mbuesch/simplepwm/schematics-atmega/simplepwm-atmega.pdf

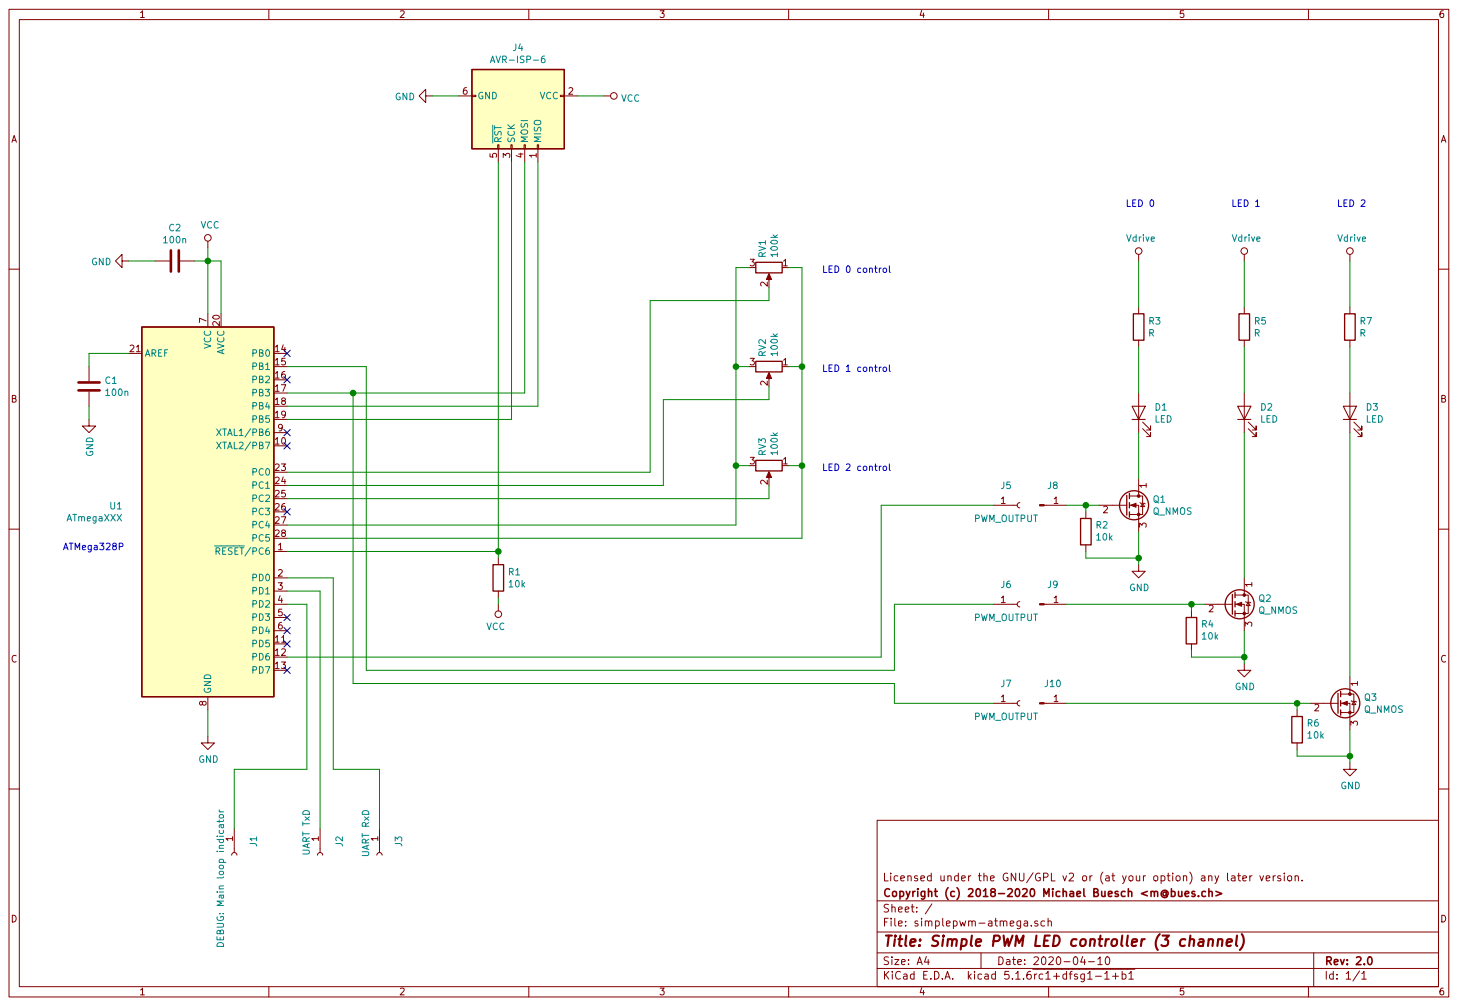
[picture p1: page 1]

LED 1 control LED 0 control

File: simplepwm-atmega.sch Sheet: / Copyright (c) 2018-2020 Michael Buesch <m@bues.ch>

Id: 1/1 Title: Simple PWM LED controller (3 channel)
