mbuesch/simplepwm/schematics-attiny/simplepwm-attiny.pdf

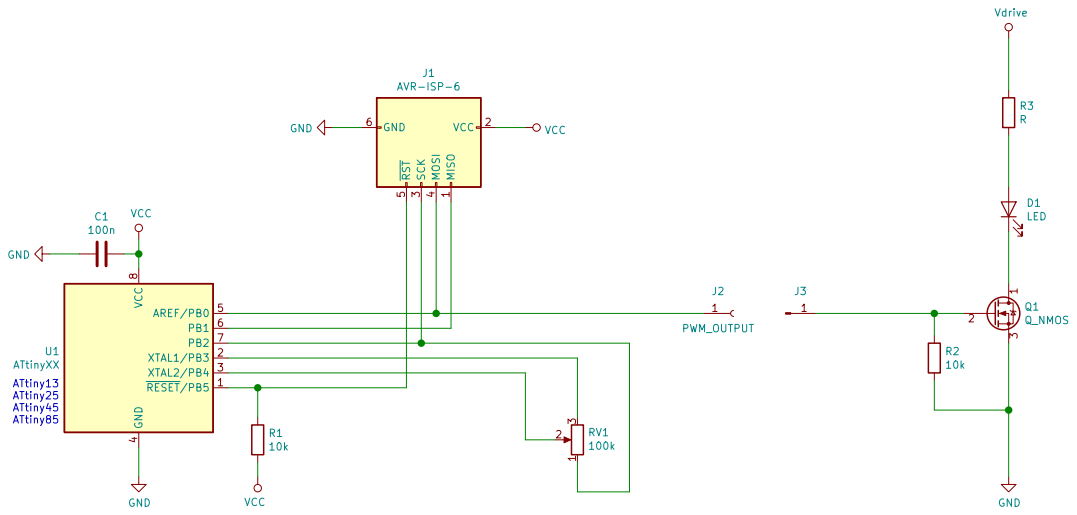
[picture p2: page 1]

Licensed under the GNU/GPL v2 or (at your option) any later version. MISO

File: simplepwm-attiny.sch Sheet: / Copyright (c) 2018-2020 Michael Buesch <m@bues.ch>

Id: 1/1 Title: Simple PWM LED controller (1 channel)
