mbuesch/simplepwm/(commit log)

2018-01-27 Fix PWM startup
2018-04-30 Add non-linear translation curve
    [brightness_curve.ods]
2018-05-01 Implement high resolution PWM for low ranges
2018-05-01 Flatten curve in the low region
    [brightness_curve.ods]
2018-05-01 Use normal PWM mode for duty cycle = 0
    This avoids the overflow interrupt in case of duty cycle = 0.
    No functional change.
    [main.c]
2018-05-01 Reset timer counter on change of prescaler
    [main.c]
2018-05-01 Remove clamp macro
2018-05-03 Simplify programming of PWM timer
2018-05-03 Rewrite handling of ADC values
    There is no need to scale to 16 bits. This can be done with the curve.
    [brightness_curve.ods]
2020-01-06 Implement some power saving features
2020-01-06 schematics: Add cache
2020-01-06 Implement BOD disable in assembly
    This ensures the timed sequence.
2020-01-06 Move pwm routines to separate c file
2020-01-07 schematics: Optimize for reduced power consumption
    [simplepwm.kicad_pcb, simplepwm.sch]
2020-01-08 Control both sides of the potentiometer from the microcontroller
    [simplepwm.sch]
2020-01-08 Makefile: Add switch for target device
2020-01-08 Move ADC code to separate source file
2020-01-08 Adc: Implement faster clock for first conversion after deep sleep
2020-01-11 Fix WDT interrupt handling
    [main.c]
2020-01-11 adc: Remove first-conversion logic
    It does not help to reduce power consumption.
2020-01-11 Switch off WDTON fuse
    Otherwise WDT interrupt won't work.
2020-01-11 Move PWM configuration to Makefile
2020-01-11 Describe high res PWM calculation
2020-01-11 pwm limit: Default to 100% (unlimited)
2020-01-12 pwm: Fix restart from deep-sleep
    Mode variable has to be reset.
    [pwm.c]
2020-01-12 pwm: Fix inverted PWM mode
    [pwm.c]
2020-01-12 pwm: Slightly reduce flash consumption on t13
2020-01-12 t13: Don't compile in potentiometer power supply switching
2020-01-12 pwm: Disable special case steps on small microcontroller
2020-01-12 Add filtering to ADC
2020-01-12 filter: Move shift value to user
2020-01-13 Add battery voltage monitoring
2020-01-13 Do not reset ADC state after battery measurement
    [adc.c, adc.h, main.c]
2020-01-13 batt: Fix ADC reference
    [adc.c]
2020-01-13 batt: Add maximum voltage threshold
2020-01-13 Add comments to battery functions
2020-01-13 Move PWM mode calculation to PWM module
2020-01-13 Move battery logic out of PWM module
2020-01-14 adc: Add function to check if bat measurement is running
2020-01-14 Fix awake from low battery protection
    [main.c]
2020-01-14 Clean up battery level definitions
2020-01-14 adc: Cleanup global variables
2020-01-14 pwm: Cleanup global variables
2020-01-16 battery: Add hysteresis
2020-01-17 adc: Add small bootstrap delay
2020-01-17 adc: Add internal function for HW config
2020-01-17 adc: Increase bootstrap time
2020-01-17 adc: Add shutdown delay
    This avoids flicker.
    [adc.c]
2020-01-17 pwm: Re-enable complex SW PWM on small device
    It still fits 1k flash
2020-01-18 pwm: Add counter to interrupt
2020-01-18 adc: Detect collision with the PWM interrupt
    In case of a collision, discard the measurement.
    This reduces noise.
    [adc.c]
2020-01-18 adc: Remove bootstrapping mechanism
2020-01-18 pwm: Add mode switching hysteresis
2020-01-18 watchdog: Enable interrupt in one step
2020-01-19 watchdog: Always revert to fast interval, if in operation
    [watchdog.c]
2020-01-19 adc: Remove shutdown delay
    It has been replaced by dynamic watchdog intervals.
    [adc.c]
2020-01-19 adc: Default invert to off
2020-01-19 adc: Use sbi to set register bits
    This reduces code size by one word.
2020-01-21 Clean up curve generation tool
    [brightness_curve.ods]
2020-01-21 watchdog: Enter slowest period, if battery voltage is critical
2020-01-22 Fix uninitialized-variable compiler warning
    [curve.c]
2020-01-22 pwm: Add function to get current setpoint
2020-01-23 watchdog: Switch to slow interval, if the battery voltage is critical
2020-01-23 battery: Correct the measured battery voltage ...
    ... by the drop caused by output load.
    [battery_drop_curve.ods]
2020-01-23 adc: Battery voltage evaluation can be done with interrupts enabled
2020-01-23 Move battery management to own module
2020-01-23 watchdog: Only use slowest interval, if battery is flat
2020-01-24 pwm: Set active setpoint to 0, if turned off
2020-01-24 Cleanup battery header
2020-01-24 Move potentiometer power control
2020-01-24 Move ods
    [battery_drop_curve.ods, brightness_curve.ods]
2020-01-25 pwm: Fix underflow of counter in IRQ mode
    [pwm.c]
2020-01-25 pwm: Improve small duty cycle on small device
2020-01-25 filter: Use saturating add
2020-03-12 compat: Add WDT and timer0 compat
2020-03-12 PRR and BOD: Add compat for more devices
2020-04-02 Makefile: Print config
2020-04-03 watchdog: Remember current standby state
2020-04-03 battery: Add moving average
2020-04-03 battery: Add RGB support
2020-04-03 adc: Add support for mux switching
2020-04-03 pwm: Add RGB support
2020-04-03 Reduced feature set on tiny25
    Flash is too small.
    [main.c, main.h]
2020-04-03 Move schematics
    [simplepwm-attiny.kicad_pcb, simplepwm-attiny.sch]
2020-04-05 adc: Reconfigure ADC for first bat conversion
2020-04-05 adc: Add missing DIDR bits
    [adc.c]
2020-04-05 adc: Count number of conversions for deep sleep trigger
2020-04-09 pwm: Force disable interrupts on shutdown
2020-04-09 debug: Defer init to after power setup
2020-04-09 adc: Use free running mode again
    It's simpler.
2020-04-09 battery: Add more debugging messages
2020-04-09 adc: Move mux switching
2020-04-10 Add atmega schematics
    [simplepwm-atmega.kicad_pcb, simplepwm-atmega.sch, simplepwm-attiny.sch]
2020-04-11 schematics: Add pull down at output stages
    [simplepwm-atmega.sch, simplepwm-attiny.sch]
2020-04-17 Move UART handling to separate module
2020-04-17 uart: Add RX handler
2020-04-17 uart: Add support for dual channel.
2020-04-19 powerdown: Use enable-macro for UART
2020-04-21 outsp: Add checks for battery voltage
2020-04-24 adc: Rename switch
2020-04-24 filter: Initialize to first value instead of starting from 0
2020-04-25 filter: Add function to preset filter value
2020-04-25 outsp: Clear filter after wakeup
2020-04-25 adc: Add helper function for hw state
2020-04-26 Add pin change interrupt wrapper
2020-04-29 adc: Add support for disabling ADC inputs
2020-04-29 uart: Add pcint wakeup support
2020-05-02 battery: Add functions to get voltage
2020-05-02 remote: Add battery support
2020-05-06 adc: Do not write outputs, if adc input has been disabled
2020-05-07 adc: Don't suppress sleep, if analog inputs are disabled
2020-05-09 uart: Check upper-bit for low byte, too
2020-05-09 uart: Add small standby suppress time to RX wakeup path
2020-05-11 Minor updates to documentation
    [simplepwm-atmega.sch]
2020-06-27 Add PWM lower range setpoint correction
    [eeprom.c, eeprom.h, pwm.c, pwm_conf.py, pwm_isr_template.c, remote.c]
2020-06-30 Fix watchdog handling, if deep sleep is disabled
    [adc.c, remote.c, watchdog.c, watchdog.h]
2020-06-30 uart: Enable odd parity
2020-06-30 uart: Propagate rx error to application layer
    [remote.c, uart.c, uart.h]
2021-07-05 remote: Add missing imports
    [bootloader.py, messages.py]
